gg232/UE-DEP/schematics/README.MD

This folder contains block diagram files and circuit diagram files.

**NOTE**: the circuit diagram files are able to be simulated. See readme in the circuit-diagrams folder for details.
