gg232/UE-DEP/schematics/circuit-diagrams/README.md

There will likely be KiCAD and Multisim schematics. As of writing this note, it is slightly easier for me to simulate in Multisim, but KiCAD is FOSS and a little better for the final stages of design.

For now, the "official" simulatable circuit schematics will be in the file format of *Multisim*.
