gg232/UE-DEP/docs/academic/original project proposal.odt

ECE 416 – Revised Proposal – Major Changes

Date: October 21, 2022 Team #: 1

Project Title: User-Extensible Digital Effects Pedal

Team members: Gerard Gallagher

1. Project objectives

This project will implement a digital effect pedal capable of loading and utilizing one or more user-supplied digital effects in the form of VST plugins. The main objective of this project is to produce a playable guitar effect pedal where the user can supply effects in the form of digital audio plugins. Previous attempts at such a pedal have been oriented towards lo-fi enthusiasts and DSP students who are comfortable coding their effects or significant portions of their system by hand. My design will attempt to make the approach as painless as possible for musicians and non-engineers, while retaining such “hackability” under the hood for audio engineers and DSP students.

2. Technical approach

The approach will be to use a Raspberry Pi 4 as a DSP unit, where the DSP algorithm is effectively specified and possibly modulated by the user

Although the algorithms used by the user are in general (almost invariably) nonlinear, the device needs to be as linear as possible within its operating range. Colloquially, this translates to the requirement that the device imparts “no color of its own” upon audio signals.

I have decided to move input and output sampling frequencies to 44.1kHz because it is plausible that the user might want to pitch-shift their performance by up to a few octaves, so a sample rate that can cover the entire audible frequency spectrum is required. The Raspberry Pi’s I2S hardware will provide the audio clock, and because it is generated by the Pi, it is controlled by the Pi and can be set through software. The ADC and DAC can both handle frequencies as low as 8kHz and as high as 384kHz, so I’ll make sure to try them during the testing phase, but preliminary tests[^1] have shown that the Raspberry Pi 4B can handle processing several effects (albeit from a USB audio interface) with a sample frequency of 44.1kHz.

Except for the RF filter on the input, all other filters will be active. The RF filter will be a simple RC passive filter designed to block RF interference. At the input, all audio input signals will go through a high-pass centered below 20Hz to kill DC from input sources and remove garbage (unwanted signal energy) from below the threshold of audibility.[^2] The output will have an anti-imaging low-pass filter with an output impedance similar to those exhibited by other guitar pedals. There will not be an audio high-pass at this stage. [^3]

I admittedly spent far too long obsessing over filter types and transfer functions to conclude that, because of the modern sigma-delta ADC and DAC architectures that naturally oversample the signal, the required specifications for the anti-aliasing filter are rather generous towards the designer.[^4] Even a competently designed passive RC filter would suffice.

The preamp will be adjustable for the user by a potentiometer mounted to the exterior of the device. Although most electric instruments have a volume knob, I would like to give the user the ability to specify the gain needed (by ear + clipping LED) when the instrument’s volume knob is at maximum gain, so that they can set the headroom of the preamp-ADC combo to suit their playing style and particular instrument.

I have used the terminology “flat” several times without further specification. This will now be done. In signals and systems, a flat frequency response is one where the frequency response is constant up to infinity, and the phase response is perfectly linear up to infinity[^5]. This is impossible to build, but even if we allow for responses that are flat only in the passband, this is still a stringent specification for my system to respond to. The frequency response is known to affect the tonal quality of a sound, and it is through the idea of “balancing frequencies” that filtering is taught to audio engineers in recording schools. However, the subject of the audibility of phase response is controversial and steeped in misinformation. Basically, “reasonable” amounts of phase distortion are not audible when applied to regular music in typical settings. It can be heard if applied to sufficiently chosen test signals, and in anechoic chambers. The seminal paper on the issue, "On the Audibility of Midrange Phase Distortion in Audio Systems" by Lipshitz, et. al.[^6], states the following four findings (emphasis is mine):

  a. Even quite small midrange phase nonlinearities can be audible on suitably chosen signals.
  b. Audibility is far greater on headphones than on loudspeakers.
  c. Simple acoustic signals generated anechoically display clear phase audibility on headphones.
  d. On normal music or speech signals phase distortion appears not to be generally audible, although it was heard with 99% confidence on some recorded vocal material.

The focus of my design is guitar signals. Although it is plausible that a user might plug a microphone into my design, vocal performances are not the focus of the project, and there already exist several better-adapted units for vocalists. To be more quantitative about this, I cite the following graph published as part of the study by Hansen and Madsen:

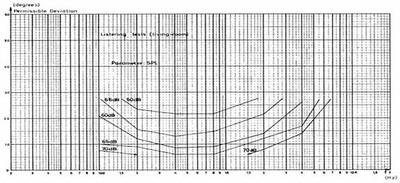
[picture p1: figure]
Hearing3

Predictably, the tolerance for phase distortion is lowest around the audio midrange, where human voices are center, and increases with frequency. As amplitude level increases, the tolerance also decreases across the board, but still seems to approach 30 degrees at some point in the audible band as frequencies fall to zero or rise to 20kHz. A caveat of this study is that it was conducted at “reasonable” levels, and guitar amplifiers are invariably “unreasonably loud,” specifically much louder than the levels participants were subjected to in this study. Additionally, it was tested with sine waves. Room acoustics make the

The short version of the above is that phase distortion should be kept low, but a little bit towards the limits of the audible band is acceptable. Specifically, if I keep it under about 5 degrees, then it should be unnoticeable for all practical purposes. The more noticeable problem will be, in my view, the frequency response of my filters, which needs to be as flat as possible in the passband.

Fortunately, filters with flatness of either frequency or phase response in the passband is very much a solved problem. A Bessel filter has a maximally flat phase response in the passband, whereas a Butterworth filter has a maximally flat frequency response. The Bessel filter’s frequency response does attenuate the upper frequencies in the passband, whereas the Butterworth filter’s phase response does distort the phase in the upper frequencies of the passband. The Bessel filter’s frequency response and Butterworth filter’s phase response are both monotonic[^7]. For audio purposes, a monotonic roll-off is better than one that is not monotonic, because such filters sound more natural. The main problem with using the Bessel filter is that it has a slow stopband roll-off, and the roll-off can be audible in the passband for low-order filters. For the high-pass filter input, because phase distortion is more acceptable in the lowest extremes of the audible band, I will use a 2nd-order Butterworth transfer function. For the low-pass filter, I will use a 3rd-order Butterworth transfer function because of the previous reason, but more importantly to ensure that the filter attenuates any supersonic frequencies that could alias down into the audible band upon sampling. The output low-pass will be a higher-order Butterworth filter, because I would like to accommodate users who want to shift their sounds close to the threshold of audibility.

Because the filters are active filters with cutoffs separated by (far more than) an octave, it is permissible to design them independently and then cascade them, as opposed to designing a narrowband asymmetrical bandpass.

I mulled over adding a notch at 60Hz to deal with ground hum, but decided against it for two reasons. Firstly, a digital notch could be trivially implemented by the user through an EQ plugin. Secondly, it is plausible that a guitarist might want to play notes near 60Hz, and even a properly designed notch could intrude in that space. A better solution is a toggleable ground lift[^8]. As soon as possible in the signal chain.

Although active filters should theoretically commute, because one of my filters will also be an amplifier, and for impedance matching purposes, it is better to amplify a filtered signal. If the signal is amplified first, it has a higher chance of clipping the filter’s op-amp.

The gain stage will also have a limiter circuit before the first op-amp and an LED indicator that flashes when the signal clips. The single-ended ADC has a full-scale value of 3V, so all signals must lie between 0V and 3V, or else they will be (horribly) distorted by clipping off the peaks. My approach here will be to implement a hard limiter at 3V exactly, but to allow the actual op-amp some extra headroom. My reasoning is that, although we are taught in introductory circuit courses that op-amps are perfectly linear except for outside their ranges of saturation, the truth of the matter is that they typically begin to gently saturate the signal for high inputs. Although “rail-to-rail” op-amps are available, ones that can run comfortably on 3V are expensive. A better solution will be to power the op-amps with 5V, then limit the output with a clipping circuit.

To that end, the filter op-amps will be JRC4580 op amps. These have a reasonably low equivalent input voltage noise of 0.8µVrms, a passable slew rate of 5V/µs[^9], and can be operated as low as +-2V (or 4V single ended).

Thus, the input block specs will be as follows:

Input RF (low pass) filter

- Transfer function = 1st order
- Filter topology = passive RC
- Cutoff = -3dB at 50kHz

Input High pass Filter

- Input impedance = 5k Ohms
- Output impedance = 5k ohms
- Transfer function = 2nd order Butterworth
- Filter topology = Sallen-and-Key
- Cutoff = -6dB at 20kHz

Input Low pass Filter

- Input impedance = 500k Ohms
- Output impedance = 5k Ohms
- Transfer function = 3rd-order Butterworth
- Filter topology = 1-opamp “Sallen- Key”[^10]
- Cutoff = -3dB at or slightly below 20 Hz

Preamp stage

- Input impedance = 500k Ohms
- Output impedance < (60k/10) Ohms
- Gain range = 0-30dB
- Amplifier topology = traditional non-inverting

Output High pass Filter

- Input impedance < 100 ohms
- Output impedance ~ 5k ohms
- Transfer function = 2nd order Butterworth
- Filter topology = Sallen-Key
- Cutoff = -6dB at 20kHz

The ADC will be a breakout board based on the Texas Instruments PCM1801.[^11] This IC is a single-ended sigma-delta ADC designed for cheap embedded audio applications. It requires both 5V power for the analog section, and 3.3V from the digital section. The input can swing between 0V and 3V max, with the stipulation that it is a single ended ADC, which means that all prior op-amp circuits need to be biased to output centered at 1.5VDC. Additionally, all op-amps prior to the ADC need to be “comfortable” working with a single-ended supply voltage of 5V and signals up to 3V. It outputs digital words in I2S or left-justified format. For this project, I will be using the I2S format.[^12]

The DAC will be a breakout board based on the Texas Instruments PCM5102A.[^13] This IC is a single-ended sigma-delta DAC designed for cheap embedded audio applications. Unlike the ADC, this one only needs 3.3V for both sections.

Both the ADC and DAC are stereo devices, meaning that there are actually two inputs and outputs. Stereo operation is unnecessary for most instruments. Guitar is inherently monophonic, although some guitar reverbs and ping-pong delay effects take advantage of stereo audio. In order for the input to be stereo, a user needs to use a stereo effect before going into my pedal. Although this is plausible, it would make a lot more sense to use my pedal to implement that effect. Stereo reverb plugins are a dime a dozen, as are ping-pong delays and any modulation effect, which stereo operation is often used for. Thus, the input will be sent to one of the ADC inputs, and the other will be left unconnected. On the other hand, the outputs will be sent as stereo outputs. Unfortunately, that means the low-pass filter and output gain control will have to be matched. C’est la vie.

After some closer reading of the Raspberry Pi’s specs, there is absolutely no way that a standard guitar pedal power supply will be sufficient to power the Raspberry Pi 4. These supplies, even the nicest ones, can typically only offer a few hundred mA of current. Keep in mind, the guitarist might want to drive other electronics on the pedalboard, such as a tuner, noise gate, or unique analog pedal for which no digital simulation exists.[^14] The Raspberry Pi 4 requires a whopping 3A of current, albeit at only 5V. Moving to a smaller model of Pi will not fix the problem. For comparison, the Electrosmash Pedal-Pi uses the Raspberry Pi Zero, which still requires 1A of current, and all other components essentially inherit all the power from the Raspberry Pi. Additionally, my understanding is that, according to Raspberry Pi documentation, the safest way to power the device is through the USB port, which is a 5V connection.

The system will be controlled primarily with the touchscreen, but secondarily through various knobs and switches external to the device. Right now, I have planned three digital knobs (rotary encoders), a footswitch toggle (separate from the bypass footswitch), an input for an expression pedal, and one sampled analog knob. Although designs vary wildly, to the point that there is not even a standard pinout, the basic principle of operation of an expression pedal is that a voltage is placed across a potentiometer operating as a voltage divider, whose action is controlled by the lever position. (There will also be at least an extra discrete resistor to limit the flow of current.) The Raspberry Pi will supply the input voltage and a MicroChip MCP3008 ADC (separate from the audio ADC) will convert the signal to SPI for the Raspberry Pi. This ADC is only 10 bits with a maximum of 200kHz sample frequency, although the limitations of SPI make such high rates impractical for the Pi. From experience, expression pedal outputs are nearly DC. If a user rocks the pedal back and forth 32 times in a second, that would yield a frequency of 32Hz, which allows for a Nyquist rate of 64Hz. Rounding up 100 Hz provides a guard band for aliasing. Note that this is a generous specification; a user who needs to oscillate the pedal will be better off doing so using software or an external MIDI CC pedal. The initial design will accommodate the pinout of a specific expression pedal, although the goal will be to implement a multi-position toggle switch that switches between the set of a few of the most common ones.

The touchscreen will be a Waveshare 4-Inch screen. The video output will be sent through HDMI, and control from the touch screen will be sent to the Pi via SPI. The touch screen requires both 3.3V power and 5V power.

My plan to distribute power is to, like the Pedal-Pi, use the on-board 3.3V and 5V pins to supply all the necessary power. Specifically, besides the nominal voltages, I need a 1.5V biasing voltage for all my op-amp filters. The Raspberry Pi’s 3.3V and 5V sources must also be filtered, as they are notoriously noisy. The USB port is used only for power, and cannot be used to access the device, so it seems feasible to simply present the USB port to the user on the outside of the case to plug into the power supply of their choosing.

The operating system will be the newest version of Raspberry Pi OS. Raspberry Pi OS is a derivative of Debian, which itself is a distribution of GNU/Linux. I will experiment with recompiling the OS with a modified real-time kernel, but if I cannot do so, the kernel will be the default. In general, music computers do not have real-time operating systems, even those at the highest-end studios, for the simple reason that Windows is not a real-time operating system. The latency of Windows with a powerful enough CPU can be optimized nearly to zero. It is a bit difficult to quantify how powerful a CPU needs to be, but it depends heavily on the number and type of effects being processed. That being said, it has been possible for over a decade to play instruments through a typical office computer.

All versions of the GNU/Linux kernel include the ALSA (Advanced Linux Sound Architecture) API (application programming interface). When properly configured, it provides kernel-level support for sound devices to interact with software. It can interface with multiple input and output devices, as well as provide support for MIDI synthesis. To control and use inputs provided by ALSA, a JACK (JACK Audio Connection Kit) audio server must be started. It is from here that the user can set inputs and outputs, and where sample rate and bit depth can be controlled, if those bit depths are available. JACK is, from experience, indispensable for low-latency audio work. All that is left from here is the VST host. Several valid choices for VST host exist, and the one which I have chosen for now is the Carla audio plugin host.[^15] Carla is a free and open source modular plugin host. It can run plugins in VST format as well as those in the LADSPA, DSSI, LV2, AU, and JSFX formats.[^16] When supplied with the correct drivers, architecture emulation, and Windows API emulation, it can run VST plugins compiled on Windows and GNU/Linux, for x86 or x64 architectures. Specifically, a software called WINE (WINE Is Not an Emulator) is used to emulate Windows API calls. To use a Windows program on GNU/Linux, one typically installs the program through WINE, then runs it through WINE every time it needs to be used. The Raspberry Pi 4B uses a CPU with an ARM64 instruction set architecture. Consequently, x86 and x64 emulation is required. The software to provide this is Box86 and Box64, respectively.

Unfortunately, I have had some trouble in getting Carla to detect the Windows API emulation and processor architecture emulation currently installed on the Pi. Because there is a pre-compiled version of Carla for Windows, if all else fails, then I will simply install the Windows version onto the system through WINE. This technique would force the entire program through WINE, as opposed to specific components. The user would also lose compatibility for plugins compiled to run on GNU/Linux distributions. However, to the best of my knowledge, no VST plugins are exclusively designed for GNU/Linux. The only plugins that are native to GNU/Linux are really those that were designed early in the development of the operating system, where it was not yet feasible to run through compatibility layers.

Additionally, I am looking to modify the source code of Carla slightly to add in dedicated bypass switches. Right now, effects can be bypassed with MIDI CC inputs or by setting their respective “Wet” knob to zero, but in my view, there is nothing so helpful as a bypass switch. Additionally, I would like to see if it is feasible to implement my controls without sending MIDI CC inputs, which might somehow get sent to instruments further down the chain. Modifying the program is perfectly acceptable, as the program is licensed under GNU GPL-2.0 license. Basically, so long as the derivative work inherits the freedoms the license originally granted and states that it is modified, it is legal to copy, modify, and redistribute the file, possibly for money. (Any code I write or modify will be made freely available to the public the moment I think it is safe for another user to use.)

I will also investigate the use of the Ardour DAW as a plugin host. The DAW is free-as-in-speech and open source.[^17] Ardour can host GNU/Linux compiled VST2 plugins, but with Carla embedded as a plugin, it can host all the plugins Carla can. Ardour is a fully featured digital audio workstation (DAW), and it is comparable to REAPER or ProTools. For a guitarist, Carla on its own would be an easier solution with a shallower learning curve, but for a recording engineer who plays guitar, Ardour would offer the most flexibility.

To make turning on the pedal a “turn-key operation,” Raspberry Pi OS needs to be programmed to do several things upon startup. Firstly, ALSA needs to be set to take input from and send output to the Raspberry Pi’s I2S ports. Next, it would be helpful to boot into a desktop environment. This way, in case anything goes wrong, the user has a “friendlier” desktop environment from which they can either reboot or reopen closed programs. Next, a JACK server needs to be started that takes in I2S input and spits out I2S output. Finally, a plugin host such as Carla needs to be opened with settings that make sense. Most obviously, Carla needs to be pointed to the JACK server, but it might make sense to load in a default session where the input is sent directly to output with an “identity operator” plugin that does nothing to demonstrate to the user how to add in a plugin. What will likely happen is that I will set up a default project file for Carla to load that has all the desired settings and plausibly some (bypassed) plugins ready to be enabled. If Ardour is used, a default project file would also be set up so that a single track is “record enabled” and set to -0dB, feeding a master track also set at -0dB, which means that there will be no attenuation or processing in general on behalf of Ardour until the user adds some.

Include hardware block diagram with power sources - mandatory.

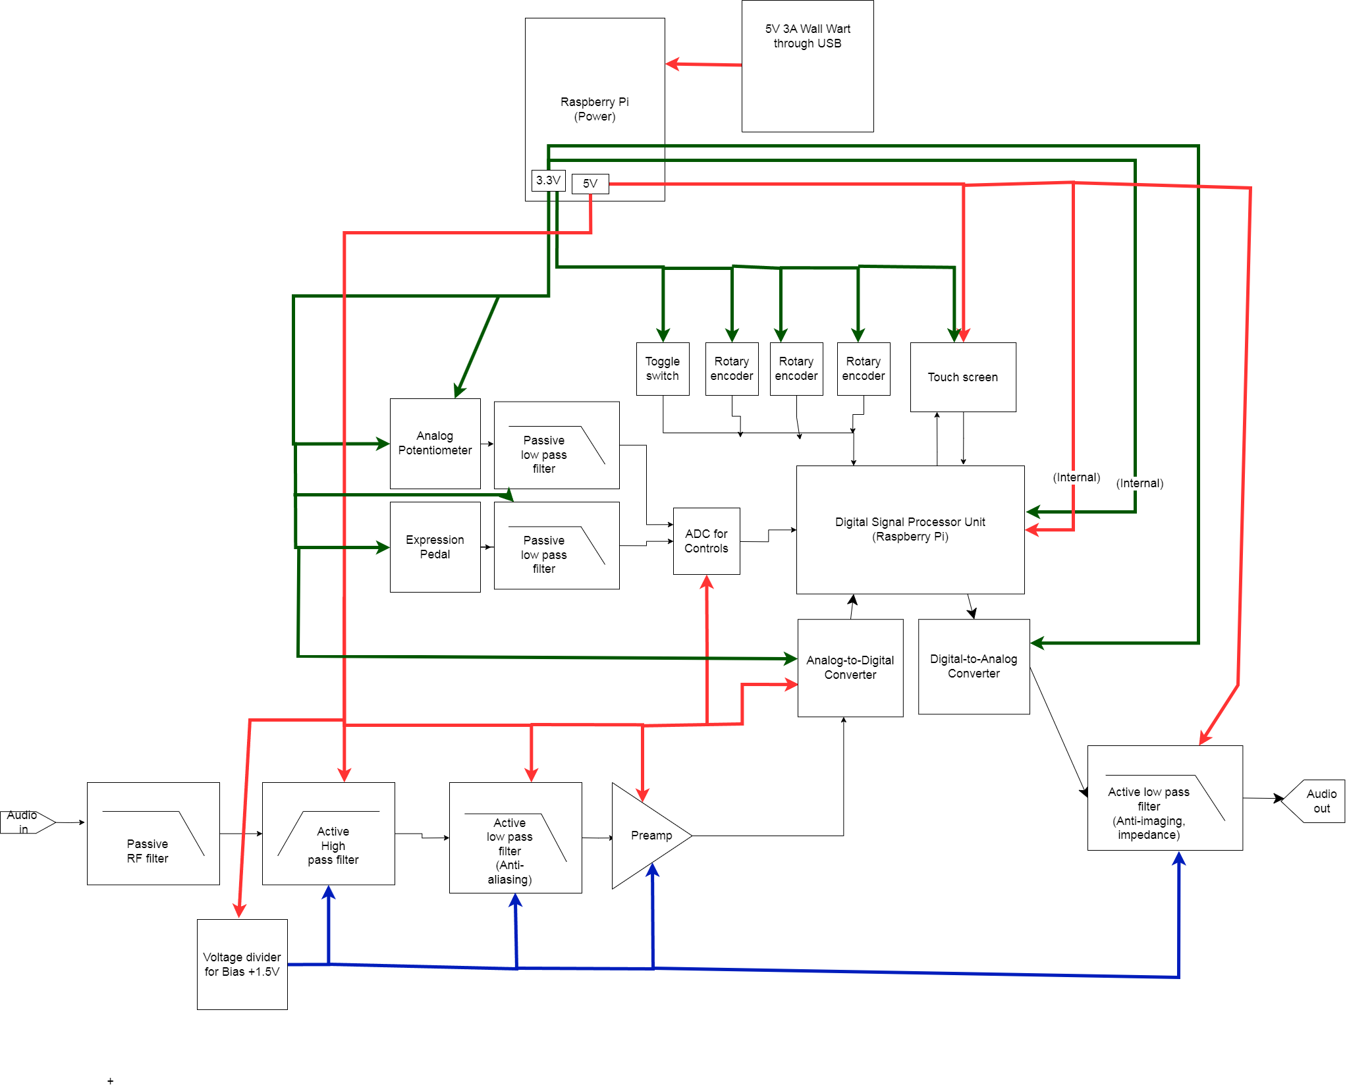
[picture p2: figure]

For the sake of readability, the power and bias wires have been colored. Specifically, 5V power is red, 3.3V power is green, and 1.5V bias for the op-amps are blue. Signal and control wires are black. For the rotary encoders, these will be completely separate GPIO inputs, but the diagram was getting cluttered. Basically, power will ultimately be handled by the Raspberry Pi 4, and the input and output op amps will need to be biased with +1.5VDC. Currently, the Pi uses a 5V 3A wall wart that plugs directly into the power supply USB port.

3. Was any preliminary work performed on this project?

The primary work was research into filter design and audio circuit idiosyncrasies that are not obvious and were not covered in depth in previous coursework. Most important is that op-amps do not act like ideal linear devices even for audio purposes, and that op-amp selection is one of the most important factors in how an audio design is going to work out. Specifically, finding low-power op amps that are not too noisy has been a challenge.

Besides that, the Raspberry Pi OS has been installed onto my Pi, and attempts were made to install the x86 and Windows compatibility software.

Additionally, I loaded a version of Carla onto my device from a binary compiled for “Debian”. It needs to be recompiled as support for a wide range of plugins is currently missing, likely due to dependency issues. As previously mentioned, I was able to get it to work with a small set of plugins. It was able to process a few JS plugins in cascade without noticeable latency.

4. What parts and components do you have and what still needs to be obtained?

Things I have

Raspberry Pi 4 Model B

ADCs (PCM1808 and MCP3008)

Resistors (1/4W and 1/2W, 0-1Mohm)

Electrolytic Capacitors

Film Capacitors

Linear and audio-taper potentiometers and plastic knobs

Op amps

Touch screen

M-Audio EX-P expression pedal

DAC (PCM5102)

XLR-1/4in combination jack

Things I need

Metal case

1. Updated Project Schedule (to be used for monitoring project progress)

Assume Week 0 is that which starts on 01/17/2022

Task or Milestone Semester week

Finalize design of input filters, input preamp, output post-amp, and output filter 1

Build input and output circuitry 2

Implement touch screen 3

Finalize audio software 4

Design and build control network, including software 6

Design and build expression inputs 8

Drill holes in case, place everything into the case 10

[^1] By “preliminary test,” I mean that I actually plugged my guitar into the Pi through a USB audio interface (Behringer UMC22) and played through it with a small set of effects.
[^2] . Most guitar gear has a high-pass threshold higher than this. My view is that, because this design is attempting to be as “flat” as possible, I should err on the side of “not filtering” rather than “too much filtering”. If a user needs a more aggressive filter, they can drop in an EQ plugin, which uses a trivial amount of resources. Additionally, many of the VST effects down the line have a high-pass filter built into them, for example distortion pedal emulators like TSE-808, which models a commonly used distortion effect whose design has a more aggressive input filter. Additionally, cascading high-pass filters at the same frequency leads not to a high-pass at the correct frequency, but to a high-pass with a higher frequency. Two filters with 3dB cutoffs at a frequency f don’t magically add to 3dB somehow; 3dB + 3dB = 6dB, which puts the new 3dB frequency somewhere too high, likely into the audible band.
[^3] Similarly, my goal is for the design to be as “flat” as possible. It is very plausible that a user will want to use effects that use most or all of the audible frequency band. For example, heavy metal guitar looks almost like pink noise to a spectrum analyzer, with significant components up to about 7 kHz, even when playing low notes. Alternatively, real-time octave-shifting effects are quite popular, and are responsible for approximately doubling the maximum frequency
[^4] Both the ADC and DAC chosen do use their respective sigma-delta architectures.
[^5] Assuming real-valued signals, the frequency response must be even, and the phase response must be odd, so specifying the negative frequency components is redundant.
[^6] If this footnote is left in, that means I could not access the cited Journal of the Audio Engineering Society articles through the NJIT library, and I cannot afford to purchase them. Thus, my results have been paraphrased from the following webpage: https://www.audioholics.com/room-acoustics/human-hearing-phase-distortion-audibility-part-2
[^7] For example, the Chebyshev Type-I filter has a horrendously non-monotonic frequency response, and is not typically used in audio, save for the rare occasion that Nyquist-rate ADC is being performed and a steep cutoff is essential. A monotonic function is one that is either monotonically increasing, decreasing, or constant. A monotonically increasing function is either increasing or constant at all points where the function is defined, specifically that y >= x implies f(y) >= f(x) for all y and x in the domain of definition. Monotonically decreasing functions are defined similarly, except that y >= x implies f(y) <= f(x). A constant function is one such that y >= x implies f(y) = f(x) for all y and x.
[^8] A “ground lift” in audio engineering is a switch that toggles a RC circuit that separates the signal ground of the input signal from the signal ground of the output signal. The assumption is that the input and output equipment each have a separate connection to ground, that one more in an interconnecting circuit is redundant, and if the guitarist finds that the extra connection is responsible for increased noise, then it can be disabled. It is commonly found in Direct Injection boxes, which are meant to translate an instrument level signal into a line level signal suitable for a mixer or other outboard gear. Still, several musicians have been killed because their equipment was not grounded.
[^9] The maximum audio frequency we could possibly hear is 20000Hz, or 20000 (cycles) per second. If a sine wave with peak at 5V and trough at 0V was injected into the op amp’s input, in order to change from 0 to 5 in 1/20000 seconds, we need a slew rate of SR=2πfV=2π20000s5V≈628×103Vs=0.628Vμs . This is the minimum required slew rate under the absolute “worst” conditions for this device, specifically maximum frequency and voltage. If the slew rate is recalculated with the correct voltage limiting for the ADC, it only needs to be 0.376Vμs Most op-amps, even very old ones, will meet this criterion.
[^10] Based on a design by Douglas Self, from The Design of Active Crossovers, pg. 212. I cite this because according to the author, this is a new design.
[^11] The “breakout board based on a PCM1808” is a Comimark PCM1808 that includes, besides the Texas Instruments IC, several capacitors and resistors. I am electing to use a breakout board because I have zero experience with SMD soldering, and I do not have the dexterity to attempt to solder surface mounted devices. The ICs only come in a TSSOP package, which is a small surface mount package type. Although the exact circuit diagram of the board is not available, it looks like they added capacitors corresponding to each of the ones called for by the “Applications” section of the ADC datasheet. These are related to DC filtering and look to be decent choices that I would have made with discrete components.
[^12] I2S is not to be confused with I2C, which will be utilized later in the project to give users touchscreen control. I2S, or Inter-IC Sound format, is specifically designed for interconnections between components on a PCB.
[^13] This breakout board is the HiLetGo PCM5102. Besides the DC filtering networks, there is an active “Line output” with a 3.5mm TRS jack, colloquially known as a “headphone jack,” and amplifier circuitry to bring it to that level. If I need an attenuator to bring the signal back down to instrument level, I will supply it. Unfortunately, I could not find any documentation about the board.
[^14] For example, consider a guitarist who uses a custom-made analog fuzz pedal as a crucial part of their signal chain. This pedal is unique and likely considered one of a kind because it is a physical pedal made from analog electronics, so a simulation of it likely will not exist, and if it ever does, it would be considered a cheap imitation. The use case of my pedal is for effects that are more commonplace, such as mainstream distortion pedals like the Proco Rat and Ibanez Tube Screamer or modulation effects, and inherently digital effects that do not really exist in analog form, such as pitch-shifters.
[^15] Ultimately, the plugin host is a choice left up to the user. For example, I could install REAPER (as I have actually done on my unit) since I own the license and there is a version for GNU/Linux. Frankly, I would prefer to use REAPER if it had Windows VST compatibility, and this could be achieved by using Carla as a plugin embedded in REAPER. However, REAPER is not free or open source, and my license explicitly prohibits me from distributing it to others. Thus, the unit needs to use a free and open source plugin host, like Carla, and REAPER will be removed from the Raspberry Pi towards the end of the project.
[^16] JSFX effects are really convenient for me as a programmer, because they are compiled just-in-time, thus written as simple text files and “fed to the machine.” They’re also light on the CPU, and they have a standardized GUI which means I don’t have to write code for knobs and sliders. Additionally, they can be easily manipulated by the user to function as they please. Any plugins written for this project will probably be JSFX.
[^17] Ardour is licensed under a GPL-2.0 license, but a user can pay for pre-compiled binaries. However, because it is under GPL-2.0, it may be modified and redistributed for any purpose. Thus, the full version of the software has made its way onto every single GNU/Linux distribution of note, including the Raspberry Pi OS, as a downloadable package which actually is free-as-in-beer. Furthermore, there is no DRM or license-enforcement software, as this is completely permissible by the GPL-2.0 license. Thus, it is perfectly legal to include Ardour within the project (so long as I adhere to the conditions of GPL-2.0) and has already been in other commercial products.
