gg232/UE-DEP/docs/academic/images/nonideal opamp.png

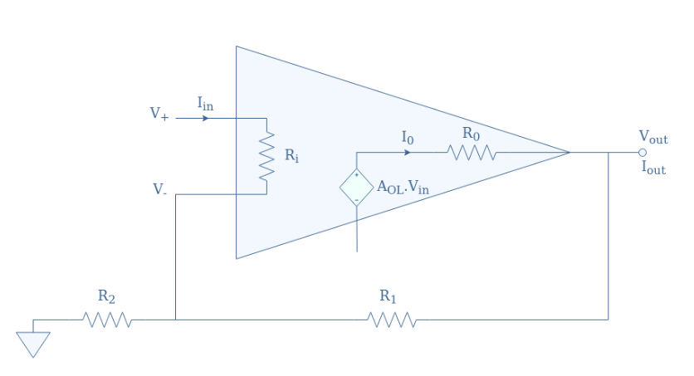
docs/academic/images/nonideal opamp.png
