gg232/UE-DEP/docs/academic/images/wiki impedance parameters.png

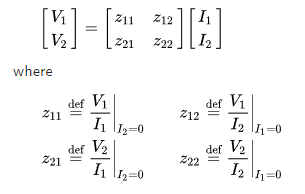
docs/academic/images/wiki impedance parameters.png
