gg232/UE-DEP/(list of files, drawings)

Other design files:
schematics/circuit-diagrams/audio input/active clamper+active clipper circuit.ms14
schematics/circuit-diagrams/audio input/input high pass.ms14
schematics/circuit-diagrams/audio input/input low pass.ms14
schematics/circuit-diagrams/audio input/passive clamper+active clipper circuit.ms14
schematics/circuit-diagrams/audio input/passive clamper+clipper circuit.ms14
schematics/circuit-diagrams/audio output/output low pass.ms14
schematics/circuit-diagrams/buffered bypass.ms14
schematics/circuit-diagrams/controls/sampled knob.ms14
