gg232/UE-DEP/(commit log)

2023-01-25 Clamper and clipper schematics added
    [active clamper+active clipper circuit.ms14, passive clamper+active clipper circuit.ms14, passive clamper+clipper circuit.ms14]
2023-01-29 Create input low pass.ms14
    [input low pass.ms14]
2023-02-01 Added input and output filter schematics
    The input and output low-passes are exactly the same now.
    [input high pass.ms14, input low pass.ms14, output low pass.ms14]
2023-02-01 Added Sampled control knob circuit
    Function of circuit depends heavily on the resistances in the voltage divider. For this reason, filter frequency will change for the expression pedal, and therefore the pedal's impedance should be measured or ballparked. Transient response is most important, so "filter perspective" might not be helpful here.
    [sampled knob.ms14]
2023-02-02 Create buffered bypass.ms14
    [buffered bypass.ms14]
